Nikhil-Vishnoi/RobotHand/BOM.xlsx

Sheet: ServoController
Servo Controller
Reference | Qty | Value | DNP | Exclude from BOM | Exclude from Board | Footprint | Datasheet | Digikey Link
C1,C2,C5,C6,C7,C4 | 6 | .1u |  |  |  | Capacitor_SMD:C_0504_1310Metric_Pad0.83x1.28mm_HandSolder | ~ | https://www.digikey.com/en/products/detail/passive-plus/0505P101JW151X/16687460?gad_campaignid=17922795960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
C3 | 1 | 1 |  |  |  | Capacitor_SMD:C_0504_1310Metric_Pad0.83x1.28mm_HandSolder | ~ | https://www.digikey.com/en/products/detail/murata-electronics/GRM155R70J105KA12D/5026378
D1 | 1 | ASMB-MTB0-0A3A2 |  |  |  | LED_SMD:LED_Avago_PLCC4_3.2x2.8mm_CW | https://docs.broadcom.com/docs/AV02-4186EN | https://www.mouser.com/ProductDetail/Broadcom-Avago/ASMB-MTB0-0B3A2?qs=pUKx8fyJudDHauriy4v3sw%3D%3D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
D2,D3 | 2 | LED |  |  |  | LED_SMD:LED_1206_3216Metric_Pad1.42x1.75mm_HandSolder | ~ | https://www.digikey.com/en/products/detail/everlight-electronics-co-ltd/QTLP650D4TR-QT15-21SYGD-S530-E2-TR8/2676153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
J1,J2,J3,J4,J7 | 5 | Conn_01x03_Pin |  |  |  | Connector_PinHeader_2.54mm:PinHeader_1x03_P2.54mm_Horizontal | ~ | https://www.digikey.com/en/products/detail/w-rth-elektronik/61300311021/4846824?gclsrc=aw.ds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
J5 | 1 | Conn_01x05_Pin |  |  |  | Connector_PinHeader_2.54mm:PinHeader_1x05_P2.54mm_Vertical | ~ | https://www.digikey.com/en/products/detail/te-connectivity-amp-connectors/9-146282-0-05/1125902?gclsrc=aw.ds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
J6 | 1 | Conn_01x02_Socket |  |  |  | Connector_PinSocket_2.54mm:PinSocket_1x02_P2.54mm_Horizontal | ~ | https://www.digikey.com/en/products/detail/sullins-connector-solutions/PPTC021LGBN-RC/775896
J8 | 1 | Barrel_Jack |  |  |  | Connector_BarrelJack:BarrelJack_Wuerth_694106106102_2.0x5.5mm | ~ | https://www.digikey.com/en/products/detail/w-rth-elektronik/694106301002/5047522?gclsrc=aw.ds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
J9 | 1 | Conn_01x06_Socket |  |  |  | Connector_PinSocket_2.54mm:PinSocket_1x06_P2.54mm_Vertical | ~ | https://www.digikey.com/en/products/detail/sullins-connector-solutions/PBC06SFCN/859987?gclsrc=aw.ds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
J10 | 1 | Conn_01x01_Pin |  |  |  | Connector_PinHeader_2.54mm:PinHeader_1x01_P2.54mm_Vertical | ~ | https://www.digikey.com/en/products/detail/te-connectivity-amp-connectors/5-146277-3/5008686?gclsrc=aw.ds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
R1,R3,R4,R2 | 4 | 270 |  |  |  | Resistor_SMD:R_0805_2012Metric_Pad1.20x1.40mm_HandSolder | ~ | https://www.digikey.com/en/products/detail/panasonic-electronic-components/ERJ-6GEYJ271V/89712
TP1,TP2,TP3 | 3 | TestPoint |  |  |  | TestPoint:TestPoint_Pad_2.5x2.5mm | ~ | Already on Board
U1 | 1 | PCA9685PW |  |  |  | Package_SO:TSSOP-28_4.4x9.7mm_P0.65mm | http://www.nxp.com/docs/en/data-sheet/PCA9685.pdf | Have
U2 | 1 | NORA-W106-00B |  |  |  | NORA-W106-00B:XCVR_NORA-W106-00B |  | Have
U3 | 1 | TC1262-33 |  |  |  | Package_TO_SOT_SMD:SOT-223-3_TabPin2 | http://ww1.microchip.com/downloads/en/DeviceDoc/21373C.pdf | https://www.digikey.com/en/products/detail/microchip-technology/TC1262-3-3VDB/1980071?gclsrc=aw.ds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
U4 | 1 | STM32L031K6Tx |  |  |  | Package_QFP:LQFP-32_7x7mm_P0.8mm | https://www.st.com/resource/en/datasheet/stm32l031k6.pdf | Get from supply closet
Servo | 5 |  |  |  |  |  |  | https://www.digikey.com/en/products/detail/hitec-commercial-solutions/31311S/12148509?gclsrc=aw.ds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
Remort Controller
Reference | Qty | Value | DNP | Exclude from BOM | Exclude from Board | Footprint | Datasheet | Digikey Buy Link
C1,C3,C4,C5,C6,C7 | 6 | .1u |  |  |  | Capacitor_SMD:C_0504_1310Metric_Pad0.83x1.28mm_HandSolder | ~ | https://www.mouser.com/ProductDetail/Samsung-Electro-Mechanics/CL05A105KQ5NNNC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
C2 | 1 | 1 |  |  |  | Capacitor_SMD:C_0504_1310Metric_Pad0.83x1.28mm_HandSolder | ~ | https://www.digikey.com/en/products/detail/murata-electronics/GRM155R70J105KA12D/5026378
D1,D2 | 2 | LED |  |  |  | LED_SMD:LED_1206_3216Metric_Pad1.42x1.75mm_HandSolder | ~ | https://www.digikey.com/en/products/detail/everlight-electronics-co-ltd/QTLP650D4TR-QT15-21SYGD-S530-E2-TR8/2676153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
D4 | 1 | ASMB-MTB0-0A3A2 |  |  |  | LED_SMD:LED_Avago_PLCC4_3.2x2.8mm_CW | https://docs.broadcom.com/docs/AV02-4186EN | https://www.mouser.com/ProductDetail/Broadcom-Avago/ASMB-MTB0-0B3A2?qs=pUKx8fyJudDHauriy4v3sw%3D%3D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
J1 | 1 | Barrel_Jack |  |  |  | Connector_BarrelJack:BarrelJack_Wuerth_694106106102_2.0x5.5mm | ~ | https://www.digikey.com/en/products/detail/w-rth-elektronik/694106301002/5047522?gclsrc=aw.ds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
J3 | 1 | Conn_01x05_Pin |  |  |  | Connector_PinHeader_2.54mm:PinHeader_1x05_P2.54mm_Vertical | ~ | https://www.digikey.com/en/products/detail/te-connectivity-amp-connectors/9-146282-0-05/1125902?gclsrc=aw.ds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
J4,J6,J7,J8,J9,J11 | 6 | Conn_01x02_Socket |  |  |  | Connector_PinSocket_2.54mm:PinSocket_1x02_P2.54mm_Horizontal | ~ | https://www.digikey.com/en/products/detail/sullins-connector-solutions/PPTC021LGBN-RC/775896
J5 | 1 | Conn_01x06_Socket |  |  |  | Connector_PinHeader_2.54mm:PinHeader_1x06_P2.54mm_Vertical | ~ | https://www.digikey.com/en/products/detail/sullins-connector-solutions/PBC06SFCN/859987?gclsrc=aw.ds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
J10 | 1 | Conn_01x01_Pin |  |  |  | Connector_PinHeader_2.54mm:PinHeader_1x01_P2.54mm_Vertical | ~ | https://www.digikey.com/en/products/detail/te-connectivity-amp-connectors/5-146277-3/5008686?gclsrc=aw.ds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
R1,R8,R9,R7 | 2 | 270 |  |  |  | Resistor_SMD:R_0805_2012Metric_Pad1.20x1.40mm_HandSolder | ~ | https://www.digikey.com/en/products/detail/panasonic-electronic-components/ERJ-6GEYJ271V/89712
R2,R3,R4,R5,R6 | 5 | 200k |  |  |  | Resistor_SMD:R_0805_2012Metric_Pad1.20x1.40mm_HandSolder | ~ | https://www.digikey.com/en/products/detail/yageo/RC0805JR-07220RL/728283
R11,R13,R14,R17,R19 | 5 | 10k |  |  |  | Resistor_SMD:R_0805_2012Metric_Pad1.20x1.40mm_HandSolder | ~ | https://www.digikey.com/en/products/detail/yageo/RC0805FR-0710KL/727535
R10,R12,R15,R16,R18 | 17 | 5k |  |  |  | Resistor_SMD:R_0805_2012Metric_Pad1.20x1.40mm_HandSolder | ~ | https://www.digikey.com/en/products/detail/vishay-dale/CRCW08055K00FKTA/5075661
TP1,TP2,TP3,TP4,TP5,TP6,TP7,TP8,TP9,TP10,TP11 | 11 | TestPoint |  |  |  | TestPoint:TestPoint_Pad_2.5x2.5mm | ~ | Already on Board
U1 | 1 | STM32L031K6Tx |  |  |  | Package_QFP:LQFP-32_7x7mm_P0.8mm | https://www.st.com/resource/en/datasheet/stm32l031k6.pdf | Get from the supply closet
U2 | 1 | TC1262-33 |  |  |  | Package_TO_SOT_SMD:SOT-223-3_TabPin2 | http://ww1.microchip.com/downloads/en/DeviceDoc/21373C.pdf | https://www.digikey.com/en/products/detail/microchip-technology/TC1262-3-3VDB/1980071?gclsrc=aw.ds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
U3 | 1 | NORA-W106-00B |  |  |  | NORA-W106-00B:XCVR_NORA-W106-00B |  | Have
U4,U5,U6,U7,U8 | 5 | LM358APE4 |  |  |  | lm358:P8 | https://www.ti.com/lit/gpn/lm358 | https://www.digikey.com/en/products/detail/texas-instruments/LM358APE4/18159207
 | 5

Sheet: Total
Reference | Qty | Value | DNP | Exclude from BOM | Exclude from Board | Footprint | Datasheet | Digikey Link | Alternatives
C1,C2,C5,C6,C7,C4 | 12 | .1u |  |  |  | Capacitor_SMD:C_0504_1310Metric_Pad0.83x1.28mm_HandSolder | ~ |  | https://www.mouser.com/ProductDetail/KYOCERA-AVX/KGM05AR71C104KN?qs=Jm2GQyTW%2FbgdxRIzvEDaJg%3D%3D
C3 | 2 | 1 |  |  |  | Capacitor_SMD:C_0504_1310Metric_Pad0.83x1.28mm_HandSolder | ~ | https://www.digikey.com/en/products/detail/murata-electronics/GRM155R70J105KA12D/5026378 | -
D1 | 2 | ASMB-MTB0-0A3A2 |  |  |  | LED_SMD:LED_Avago_PLCC4_3.2x2.8mm_CW | https://docs.broadcom.com/docs/AV02-4186EN | https://www.mouser.com/ProductDetail/Broadcom-Avago/ASMB-MTB0-0B3A2?qs=pUKx8fyJudDHauriy4v3sw%3D%3D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 | -
D2,D3 | 4 | LED |  |  |  | LED_SMD:LED_1206_3216Metric_Pad1.42x1.75mm_HandSolder | ~ | https://www.digikey.com/en/products/detail/everlight-electronics-co-ltd/QTLP650D4TR-QT15-21SYGD-S530-E2-TR8/2676153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 | -
R1,R8,R9,R7 | 8 | 330 |  |  |  | Resistor_SMD:R_0805_2012Metric_Pad1.20x1.40mm_HandSolder | ~ | https://www.digikey.com/en/products/detail/panasonic-electronic-components/ERJ-6GEYJ271V/89712 | ECEB Store Has it Dont Buy
R2,R3,R4,R5,R6 | 5 | 200k |  |  |  | Resistor_SMD:R_0805_2012Metric_Pad1.20x1.40mm_HandSolder | ~ | https://www.digikey.com/en/products/detail/yageo/RT0805BRE07200KL/1076266 | -
R11,R13,R14,R17,R19 | 5 | 1.5k |  |  |  | Resistor_SMD:R_0805_2012Metric_Pad1.20x1.40mm_HandSolder | ~ | https://www.digikey.com/en/products/detail/yageo/RC0805FR-0710KL/727535 | ECEB Store Has it Dont Buy
R10,R12,R15,R16,R18 | 17 | 1k |  |  |  | Resistor_SMD:R_0805_2012Metric_Pad1.20x1.40mm_HandSolder | ~ | https://www.digikey.com/en/products/detail/vishay-dale/CRCW08055K00FKTA/5075661 | ECEB Store Has it Dont Buy
U4,U5,U6,U7,U8 | 5 | LM358APE4 |  |  |  | lm358:P8 | https://www.ti.com/lit/gpn/lm358 | https://www.digikey.com/en/products/detail/texas-instruments/LM358APE4/18159207 | -
J1,J2,J3,J4,J7 | 5 | Conn_01x03_Pin |  |  |  | Connector_PinHeader_2.54mm:PinHeader_1x03_P2.54mm_Horizontal | ~ | https://www.digikey.com/en/products/detail/w-rth-elektronik/61300311021/4846824?gclsrc=aw.ds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 | -
J5 | 2 | Conn_01x05_Pin |  |  |  | Connector_PinHeader_2.54mm:PinHeader_1x05_P2.54mm_Vertical | ~ | https://www.digikey.com/en/products/detail/te-connectivity-amp-connectors/9-146282-0-05/1125902?gclsrc=aw.ds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 | -
J6 | 7 | Conn_01x02_Socket |  |  |  | Connector_PinSocket_2.54mm:PinSocket_1x02_P2.54mm_Horizontal | ~ | https://www.digikey.com/en/products/detail/sullins-connector-solutions/PPTC021LGBN-RC/775896 | -
J8 | 2 | Barrel_Jack |  |  |  | Connector_BarrelJack:BarrelJack_Wuerth_694106106102_2.0x5.5mm | ~ | https://www.digikey.com/en/products/detail/w-rth-elektronik/694106301002/5047522?gclsrc=aw.ds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 | -
J9 | 2 | Conn_01x06_Socket |  |  |  | Connector_PinSocket_2.54mm:PinSocket_1x06_P2.54mm_Vertical | ~ | https://www.digikey.com/en/products/detail/sullins-connector-solutions/PBC06SFCN/859987?gclsrc=aw.ds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 | -
J10 | 2 | Conn_01x01_Pin |  |  |  | Connector_PinHeader_2.54mm:PinHeader_1x01_P2.54mm_Vertical | ~ | https://www.digikey.com/en/products/detail/te-connectivity-amp-connectors/5-146277-3/5008686?gclsrc=aw.ds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 | -
U1 | 1 | PCA9685PW |  |  |  | Package_SO:TSSOP-28_4.4x9.7mm_P0.65mm | http://www.nxp.com/docs/en/data-sheet/PCA9685.pdf | Have
U2 | 2 | NORA-W106-00B |  |  |  | NORA-W106-00B:XCVR_NORA-W106-00B |  | Have
U3 | 2 | TC1262-33 |  |  |  | Package_TO_SOT_SMD:SOT-223-3_TabPin2 | http://ww1.microchip.com/downloads/en/DeviceDoc/21373C.pdf | https://www.digikey.com/en/products/detail/microchip-technology/TC1262-3-3VDB/1980071?gclsrc=aw.ds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 | -
U4 | 6 | STM32L031K6Tx |  |  |  | Package_QFP:LQFP-32_7x7mm_P0.8mm | https://www.st.com/resource/en/datasheet/stm32l031k6.pdf | https://www.digikey.com/en/products/detail/stmicroelectronics/STM32L031K6T6/6166978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..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 | -
Charger | 2 |  |  |  |  |  |  | https://www.walmart.com/ip/JacobsParts-5V-4A-20W-Power-Adapter-for-USB-Hubs-and-Other-5V-Devices-5-5mm-x-2-1mm/5750976615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 | -
Servo | 3 |  |  |  |  |  |  | https://hitecrcd.com/hs-311-standard-economy-servo/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 | -
Battery Pack | 1 |  |  |  |  |  |  | https://www.digikey.com/en/products/detail/digikey-standard/DKS-2AAF/17038790?gclsrc=aw.ds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 | -
Digikey Order | https://www.digikey.com/short/3p9089w3
Mouser Order | https://www.mouser.com/Tools/SavedCart/Share?AccessID=e82e5d9639
