Nikhil-Vishnoi/RobotHand/PCB/RemoteControl/RemoteControl.kicad_pcb

## KiCad design PCB/RemoteControl/RemoteControl.kicad_pcb (2025-10-26)

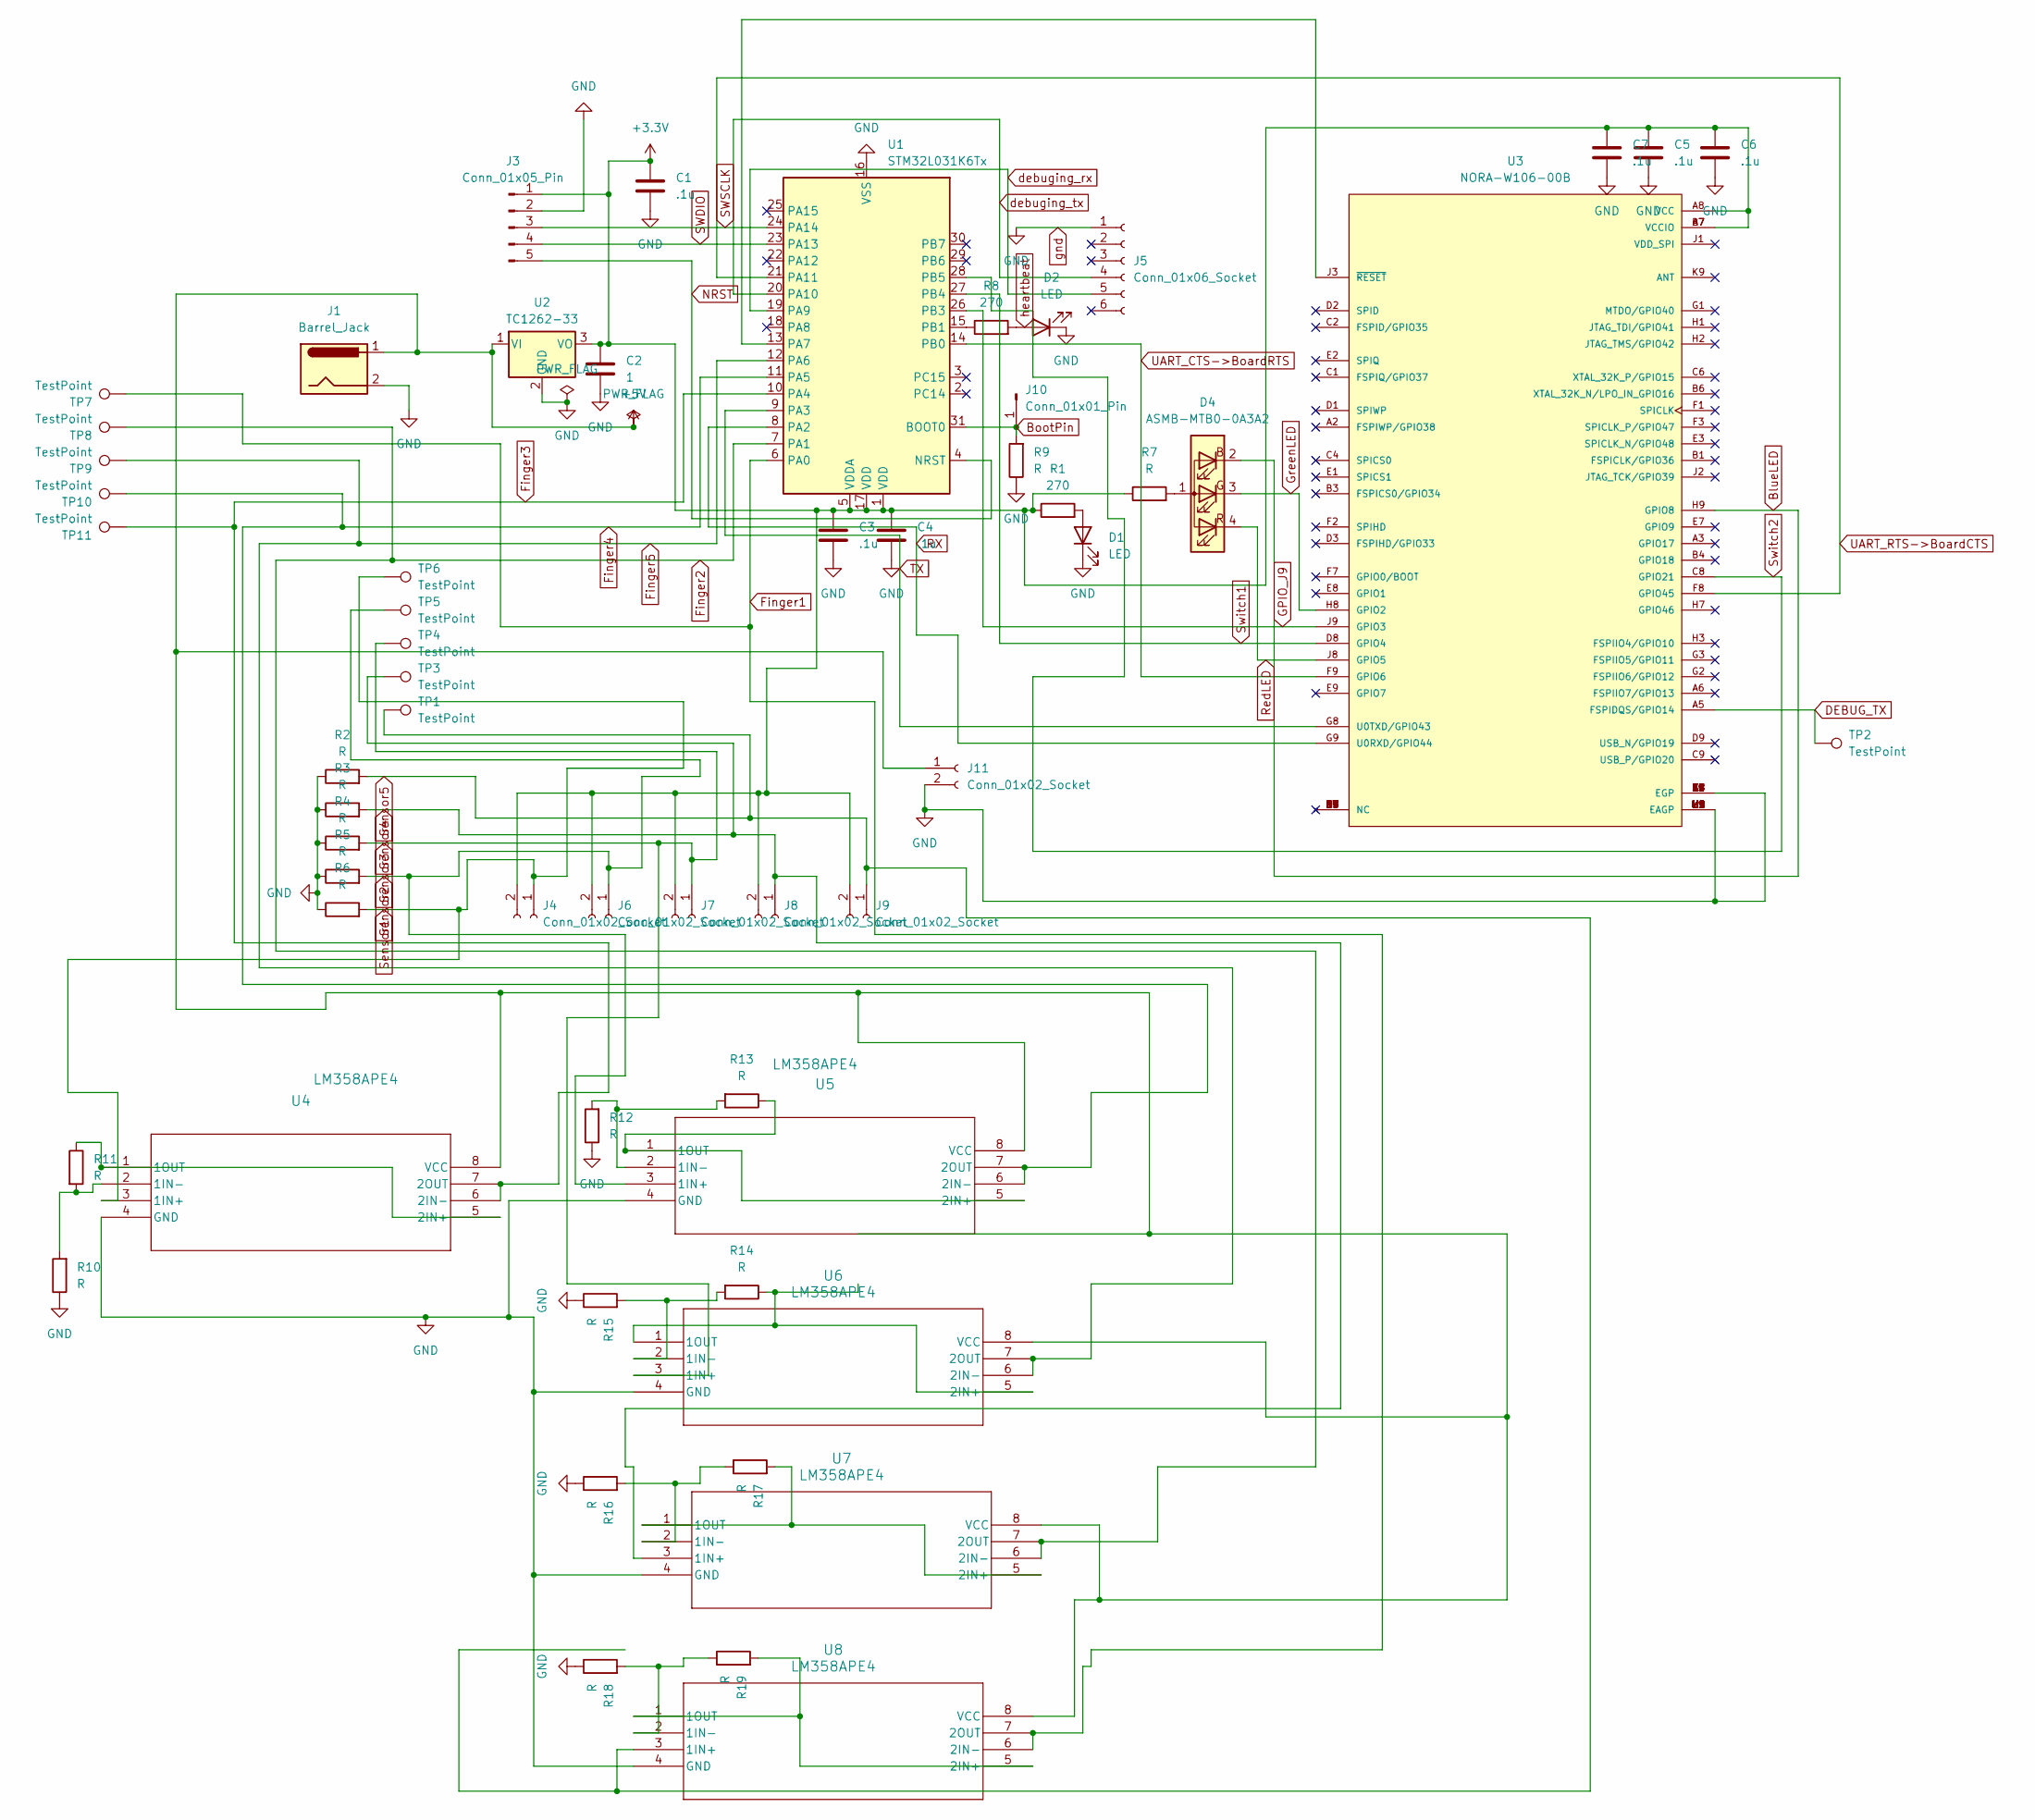
[picture p1: schematic RemoteControl.kicad_sch]

Parts:
C1, C3, C4, C5, C6, C7: .1u; C_0805_2012Metric_Pad1.18x1.45mm_HandSolder
C2: 1; C_0805_2012Metric_Pad1.18x1.45mm_HandSolder
D1, D2: LED; LED_1206_3216Metric_Pad1.42x1.75mm_HandSolder
D4: ASMB-MTB0-0A3A2; LED_Avago_PLCC4_3.2x2.8mm_CW
J1: Barrel_Jack; BarrelJack_Wuerth_694106106102_2.0x5.5mm
J3: Conn_01x05_Pin; PinHeader_1x05_P2.54mm_Vertical
J4, J6, J7, J8, J9, J11: Conn_01x02_Socket; PinSocket_1x02_P2.54mm_Horizontal
J5: Conn_01x06_Socket; PinHeader_1x06_P2.54mm_Vertical
J10: Conn_01x01_Pin; PinHeader_1x01_P2.54mm_Vertical
R1, R8: 270; R_0805_2012Metric_Pad1.20x1.40mm_HandSolder
R2, R3, R4, R5, R6, R7, R9, R10, R11, R12, R13, R14, R15, R16, R17, R18, R19: R; R_0805_2012Metric_Pad1.20x1.40mm_HandSolder
TP1, TP2, TP3, TP4, TP5, TP6, TP7, TP8, TP9, TP10, TP11: TestPoint; TestPoint_Pad_2.5x2.5mm
U1: STM32L031K6Tx; LQFP-32_7x7mm_P0.8mm
U2: TC1262-33; SOT-223-3_TabPin2
U3: NORA-W106-00B; XCVR_NORA-W106-00B; PARTREV R03
U4, U5, U6, U7, U8: LM358APE4; P8

Connections:
+3.3V: C1.1, C2.1, C3.1, C4.1, C5.1, C6.1, C7.1, J3.1, J4.2, J6.2, J7.2, J8.2, J9.2, R1.1, R7.1, U1.1 (VDD), U1.5 (VDDA), U1.17 (VDD), U2.3 (VO), U3.A7 (VCCIO), U3.A8 (VCC), U3.B7 (VCCIO)
+5V: J1.1, J11.1, U2.1 (VI), U4.8 (VCC), U5.8 (VCC), U6.8 (VCC), U7.8 (VCC), U8.8 (VCC)
BlueLED: D4.2 (BK), U3.H9 (GPIO8)
BootPin: J10.1, R9.2, U1.31 (BOOT0)
DEBUG_TX: TP2.1, U3.A5 (FSPIDQS/GPIO14)
Finger1: TP7.1, U1.6 (PA0), U8.6 (2IN-), U8.7 (2OUT)
Finger2: TP8.1, U1.7 (PA1), U7.6 (2IN-), U7.7 (2OUT)
Finger3: TP11.1, U1.10 (PA4), U4.6 (2IN-), U4.7 (2OUT)
Finger4: TP10.1, U1.11 (PA5), U5.6 (2IN-), U5.7 (2OUT)
Finger5: TP9.1, U1.12 (PA6), U6.6 (2IN-), U6.7 (2OUT)
GPIO_J9: U1.26 (PB3), U3.J9 (GPIO3)
GreenLED: D4.3 (GK), U3.H8 (GPIO2)
NRST: J3.5, U1.4 (NRST)
unnamed: D1.2 (A), R1.2
unnamed: D2.2 (A), R8.2
unnamed: D4.1 (A), R7.2
unnamed: U1.13 (PA7), U3.J3 (~RESET)
unnamed: R8.1, U1.15 (PB1)
unnamed: R10.2, R11.2, U4.2 (1IN-)
unnamed: R11.1, U4.1 (1OUT), U4.5 (2IN+)
unnamed: R12.2, R13.2, U5.2 (1IN-)
unnamed: R13.1, U5.1 (1OUT), U5.5 (2IN+)
unnamed: R14.2, R15.2, U6.2 (1IN-)
unnamed: R14.1, U6.1 (1OUT), U6.5 (2IN+)
unnamed: R16.2, R17.1, U7.2 (1IN-)
unnamed: R17.2, U7.1 (1OUT), U7.5 (2IN+)
unnamed: R18.2, R19.1, U8.2 (1IN-)
unnamed: R19.2, U8.1 (1OUT), U8.5 (2IN+)
RX: U1.8 (PA2), U3.G9 (U0RXD/GPIO44)
RedLED: D4.4 (RK), U3.J8 (GPIO5)
SWDIO: J3.4, U1.23 (PA13)
SWSCLK: J3.3, U1.24 (PA14)
Sensor1: J4.1, R6.2, TP6.1, U4.3 (1IN+)
Sensor2: J6.1, R5.2, TP5.1, U5.3 (1IN+)
Sensor3: J7.1, R4.2, TP4.1, U6.3 (1IN+)
Sensor4: J8.1, R3.2, TP3.1, U7.3 (1IN+)
Sensor5: J9.1, R2.2, TP1.1, U8.3 (1IN+)
Switch1: U1.27 (PB4), U3.D8 (GPIO4)
Switch2: U1.28 (PB5), U3.C8 (GPIO21)
TX: U1.9 (PA3), U3.G8 (U0TXD/GPIO43)
UART_CTS->BoardRTS: U1.14 (PB0), U3.F9 (GPIO6)
UART_RTS->BoardCTS: U1.21 (PA11), U3.F8 (GPIO45)
debuging_rx: J5.5, U1.19 (PA9)
debuging_tx: J5.4, U1.20 (PA10)
gnd: C1.2, C2.2, C3.2, C4.2, C5.2, C6.2, C7.2, D1.1 (K), D2.1 (K), J1.2, J3.2, J5.1, J11.2, R2.1, R3.1, R4.1, R5.1, R6.1, R9.1, R10.1, R12.1, R15.1, R16.1, R18.1, U1.16 (VSS), U1.32 (VSS), U2.2 (GND), U3.A1 (EGP), U3.A9 (EGP), U3.B2 (EGP), U3.B8 (EGP), U3.E4 (EGP), U3.E5 (EGP), U3.F4 (EGP), U3.F5 (EGP), U3.K2 (EGP), U3.K3 (EGP), U3.K5 (EGP), U3.K7 (EGP), U3.K8 (EGP), U3.L1 (EAGP), U3.L9 (EAGP), U3.M1 (EAGP), U3.M2 (EAGP), U3.M8 (EAGP), U3.M9 (EAGP), U4.4 (GND), U5.4 (GND), U6.4 (GND), U7.4 (GND), U8.4 (GND)

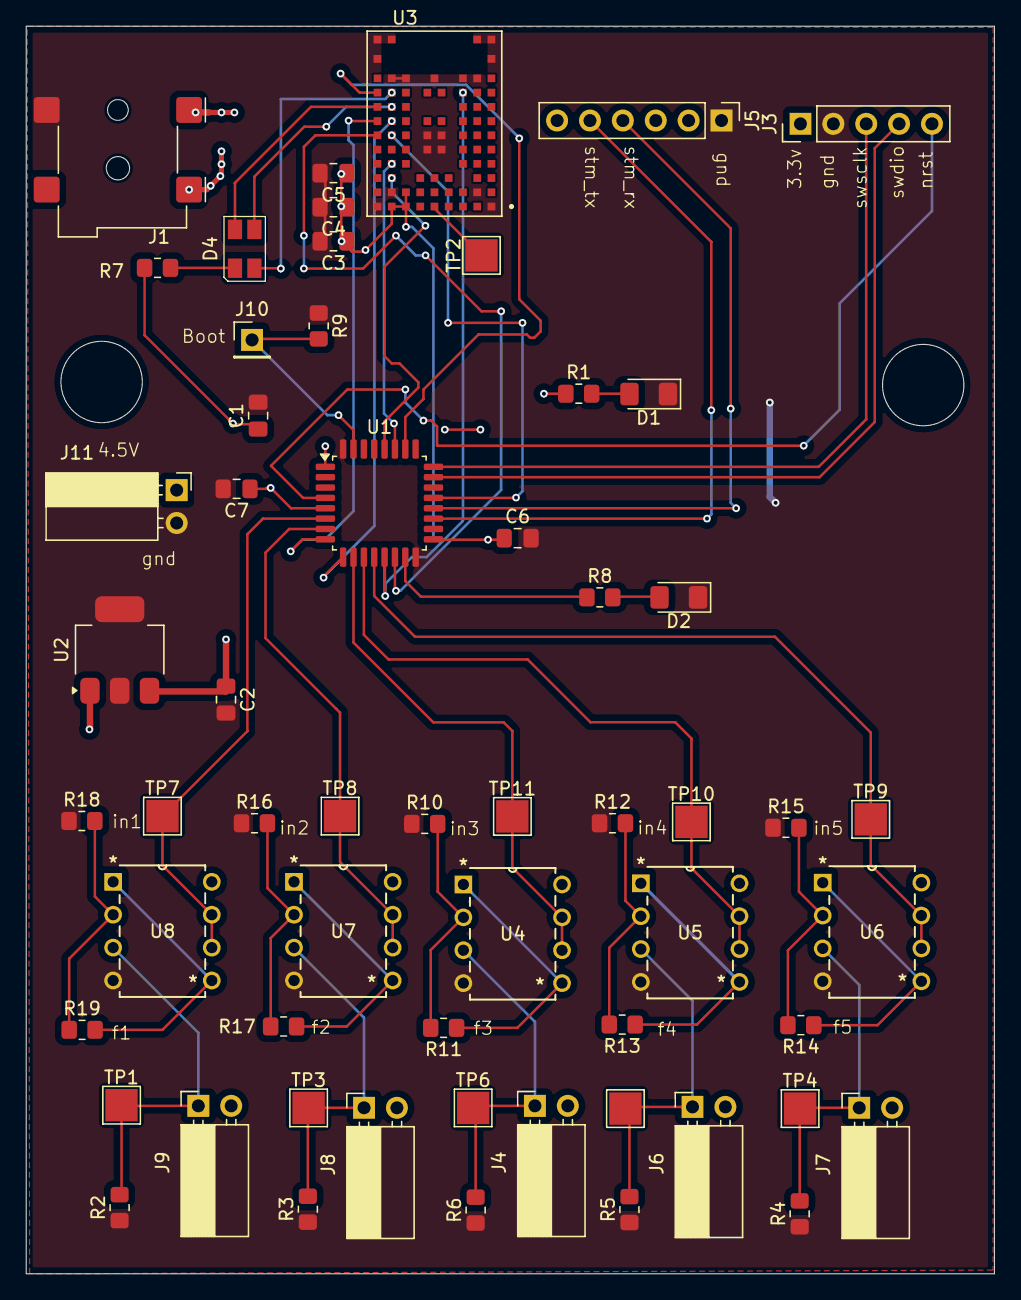
[picture p2: board RemoteControl.kicad_pcb from above]

Board: 2 copper layers, 74.8 x 96.4 mm, 58 parts (0 on the bottom side), 45 nets.
