Nikhil-Vishnoi/RobotHand/PCB/MotorControl/MotorControl.kicad_pcb

## KiCad design PCB/MotorControl/MotorControl.kicad_pcb (2025-10-26)

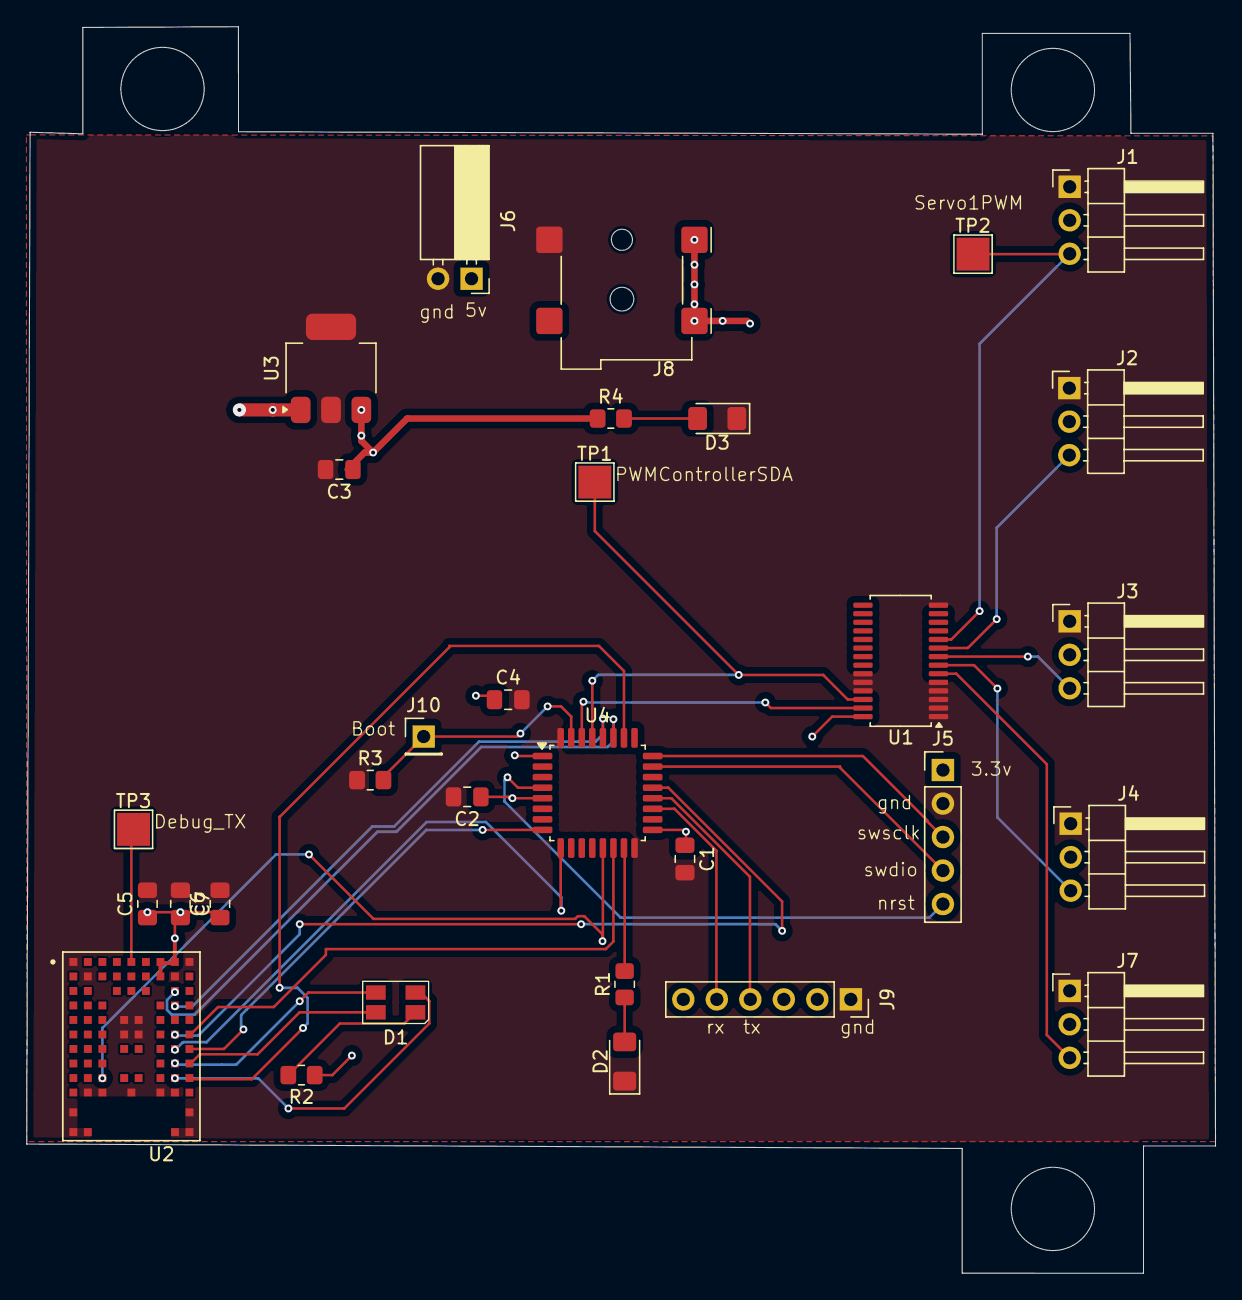
[picture p3: board MotorControl.kicad_pcb from above]

Board: 2 copper layers, 90.1 x 94.5 mm, 31 parts (0 on the bottom side), 32 nets.

Parts:
C1, C2, C5, C6, C7: C; C_0805_2012Metric_Pad1.18x1.45mm_HandSolder
C3: 1; C_0805_2012Metric_Pad1.18x1.45mm_HandSolder
C4: .1u; C_0805_2012Metric_Pad1.18x1.45mm_HandSolder
D1: ASMB-MTB0-0A3A2; LED_Avago_PLCC4_3.2x2.8mm_CW
D2, D3: LED; LED_1206_3216Metric_Pad1.42x1.75mm_HandSolder
J1, J2, J3, J4, J7: Conn_01x03_Pin; PinHeader_1x03_P2.54mm_Horizontal
J5: Conn_01x05_Pin; PinHeader_1x05_P2.54mm_Vertical
J6: Conn_01x02_Socket; PinSocket_1x02_P2.54mm_Horizontal
J8: Barrel_Jack; BarrelJack_Wuerth_694106106102_2.0x5.5mm
J9: Conn_01x06_Socket; PinSocket_1x06_P2.54mm_Vertical
J10: Conn_01x01_Pin; PinHeader_1x01_P2.54mm_Vertical
R1, R3, R4: 270; R_0805_2012Metric_Pad1.20x1.40mm_HandSolder
R2: R; R_0805_2012Metric_Pad1.20x1.40mm_HandSolder
TP1, TP2, TP3: TestPoint; TestPoint_Pad_2.5x2.5mm
U1: PCA9685PW; TSSOP-28_4.4x9.7mm_P0.65mm
U2: NORA-W106-00B; XCVR_NORA-W106-00B
U3: TC1262-33; SOT-223-3_TabPin2
U4: STM32L031K6Tx; LQFP-32_7x7mm_P0.8mm

Connections:
5V: J1.2, J2.2, J3.2, J4.2, J6.1, J7.2, J8.1, U3.1 (VI)
+3.3V: C1.1, C2.1, C3.1, C4.1, C5.1, C6.1, C7.2, J5.1, R2.1, R4.1, U1.28 (VDD), U2.A7 (VCCIO), U2.A8 (VCC), U2.B7 (VCCIO), U3.3 (VO), U4.1 (VDD), U4.5 (VDDA), U4.17 (VDD)
BlueLED: D1.2 (BK), U2.H9 (GPIO8)
Boot: J10.1, R3.2, U4.31 (BOOT0)
DebugTX: TP3.1, U2.A5 (FSPIDQS/GPIO14)
Debug_rx: J9.5, U4.19 (PA9)
Debug_tx: J9.4, U4.20 (PA10)
GND: C1.2, C2.2, C3.2, C4.2, C5.2, C6.2, C7.1, D2.1 (K), D3.1 (K), J1.1, J2.1, J3.1, J4.1, J5.2, J6.2, J7.1, J8.2, J9.1, R3.1, U1.1 (A0), U1.2 (A1), U1.3 (A2), U1.4 (A3), U1.5 (A4), U1.14 (VSS), U1.23 (~OE), U1.24 (A5), U1.25 (EXTCLK), U2.A1 (EGP), U2.A9 (EGP), U2.B2 (EGP), U2.B8 (EGP), U2.E4 (EGP), U2.E5 (EGP), U2.F4 (EGP), U2.F5 (EGP), U2.K2 (EGP), U2.K3 (EGP), U2.K5 (EGP), U2.K7 (EGP), U2.K8 (EGP), U2.L1 (EAGP), U2.L9 (EAGP), U2.M1 (EAGP), U2.M2 (EAGP), U2.M8 (EAGP), U2.M9 (EAGP), U3.2 (GND), U4.16 (VSS), U4.32 (VSS)
GPIO_J9: U2.J9 (GPIO3), U4.26 (PB3)
GreenLED: D1.3 (GK), U2.H8 (GPIO2)
HeartBeat: R1.2, U4.15 (PB1)
Motor1PWM: J1.3, TP2.1, U1.10 (LED4)
MotorControl_SCL: TP1.1, U1.26 (SCL), U4.29 (PB6)
NRST: J5.5, U4.4 (NRST)
unnamed: D1.1 (A), R2.2
unnamed: D2.2 (A), R1.1
unnamed: D3.2 (A), R4.2
unnamed: J2.3, U1.9 (LED3)
unnamed: J3.3, U1.8 (LED2)
unnamed: J4.3, U1.7 (LED1)
unnamed: J7.3, U1.6 (LED0)
unnamed: U1.27 (SDA), U4.30 (PB7)
unnamed: U2.J3 (~RESET), U4.13 (PA7)
RX: U2.G8 (U0TXD/GPIO43), U4.9 (PA3)
RedLED: D1.4 (RK), U2.J8 (GPIO5)
SWDIO: J5.4, U4.23 (PA13)
SWSCLK: J5.3, U4.24 (PA14)
Switch1: U2.D8 (GPIO4), U4.28 (PB5)
Switch2: U2.C8 (GPIO21), U4.27 (PB4)
TX: U2.G9 (U0RXD/GPIO44), U4.8 (PA2)
UART_CTS->Board_RTS: U2.F9 (GPIO6), U4.14 (PB0)
UART_RTS->Board_CTS: U2.F8 (GPIO45), U4.21 (PA11)
