Nikhil-Vishnoi/RobotHand/STM32_Remote/Core/Src/main.c

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
/* Includes ------------------------------------------------------------------*/
#include "main.h"

/* USER CODE BEGIN Includes */
#include "Nora.h"
/* USER CODE END Includes */

ADC_HandleTypeDef hadc;
DMA_HandleTypeDef hdma_adc;

UART_HandleTypeDef hlpuart1;
UART_HandleTypeDef huart2;

void SystemClock_Config(void);
static void MX_GPIO_Init(void);
static void MX_DMA_Init(void);
static void MX_ADC_Init(void);
static void MX_LPUART1_UART_Init(void);
static void MX_USART2_UART_Init(void);
/* USER CODE BEGIN PFP */
UART_HandleTypeDef* getNoraPort(){
	return &hlpuart1;
}
UART_HandleTypeDef* getDebugPort(){
	return &huart2;
}
/* USER CODE END PFP */

/**
  * @brief  The application entry point.
  * @retval int
  */
int main(void)
{

  /* MCU Configuration--------------------------------------------------------*/

  /* Reset of all peripherals, Initializes the Flash interface and the Systick. */
  HAL_Init();

  /* Configure the system clock */
  SystemClock_Config();

  /* Initialize all configured peripherals */
  MX_GPIO_Init();
  MX_DMA_Init();
  MX_ADC_Init();
  MX_LPUART1_UART_Init();
  MX_USART2_UART_Init();
  /* USER CODE BEGIN 2 */
//  // boot up uconnect press
//  Nora_startup();

  static uint16_t adc_val[5];
  HAL_ADC_Start_DMA(&hadc, adc_val, 5);
  int thm, im, mm, rm, pm, ths, is, ms, rs, ps;
  thm = -1;
  im = -1;
  mm = -1;
  rm = -1;
  pm = -1;
  ths = -1;
  is = -1;
  ms = -1;
  rs = -1;
  ps = -1;
  /* USER CODE END 2 */

  /* Infinite loop */
  /* USER CODE BEGIN WHILE */
  while (1)
  {
    /* USER CODE END WHILE */

    /* USER CODE BEGIN 3 */
//	  i++;
//	  Nora_command("AT\r\n");
	  HAL_ADC_Start(&hadc);
	  HAL_Delay(50);
	  HAL_GPIO_WritePin(LED_GPIO_Port, LED_Pin, GPIO_PIN_SET);
	  char str_buffer[500];
	  if(thm == -1 || thm < adc_val[4]) {
		  thm = adc_val[4];
	  }
	  if(im == -1 || im < adc_val[3]) {
		  im = adc_val[3];
	  }
	  if(mm == -1 || mm < adc_val[2]) {
		  mm = adc_val[2];
	  }
	  if(rm == -1 || rm < adc_val[1]) {
		  rm = adc_val[1];
	  }
	  if(pm == -1 || pm < adc_val[0]) {
		  pm = adc_val[0];
	  }
	  if(ths == -1) {
		  ths = adc_val[4]/2;
	  }
	  if(is == -1) {
		  is = adc_val[3]/2;
	  }
	  if(ms == -1 ) {
		  ms = adc_val[2]/2;
	  }
	  if(rs == -1) {
		  rs = adc_val[1]/2;
	  }
	  if(ps == -1) {
		  ps = adc_val[0]/2;
	  }
	  if(ths > adc_val[4]) {
		  ths = adc_val[4];
	  }
	  if(is > adc_val[3]) {
		  is = adc_val[3];
	  }
	  if(ms > adc_val[2]) {
		  ms = adc_val[2];
	  }
	  if(rs > adc_val[1]) {
		  rs = adc_val[1];
	  }
	  if(ps > adc_val[0]) {
		  ps = adc_val[0];
	  }



//	  sprintf(str_buffer,"\r\nPinky: %u | Ring: %u | Middle 3: %u | Index 4: %u | Thumb 5: %u \r\n\0",adc_val[0],adc_val[1],adc_val[2],adc_val[3],adc_val[4]);
//
////	  if(i == 1)
//	  HAL_UART_Transmit(&huart2,str_buffer,strlen(str_buffer),5000);
//	  sprintf(str_buffer,"\r\nMaxes Pinky: %u | Ring: %u | Middle 3: %u | Index 4: %u | Thumb 5: %u \r\n\0",
//			  pm,rm,mm,im,thm);
//	  HAL_UART_Transmit(&huart2,str_buffer,strlen(str_buffer),5000);
//	  sprintf(str_buffer,"\r\nMins Pinky: %u | Ring: %u | Middle 3: %u | Index 4: %u | Thumb 5: %u \r\n\0",
//			  ps,rs,ms,is,ths);
//	  HAL_UART_Transmit(&huart2,str_buffer,strlen(str_buffer),5000);
//	  sprintf(str_buffer,
//	      "\r\nAngles Pinky: %3d | Ring: %3d | Middle: %3d | Index: %3d | Thumb: %3d\r\n\0",
//	      (adc_val[0] - ps) * 180 / (pm - ps),
//	      (adc_val[1] - rs) * 180 / (rm - rs),
//	      (adc_val[2] - ms) * 180 / (mm - ms),
//	      (adc_val[3] - is) * 180 / (im - is),
//	      (adc_val[4] - ths) * 180 / (thm - ths)
//	  );
	  sprintf(str_buffer,
	  	      "%c%c%c%c%c",
	  	      (adc_val[0] - ps) * 180 / (pm - ps),
			  (adc_val[1] - rs) * 180 / (rm - rs),
			  180-(adc_val[2] - ms) * 180 / (mm - ms),
			  (adc_val[3] - is) * 180 / (im - is),
			  180-(adc_val[4] - ths) * 180 / (thm - ths)
	  	  );
//	  sprintf(str_buffer,"\r\nPinky: %u | Ring: %u | Middle 3: %u | Index 4: %u | Thumb 5: %u \r\n\0",
//			  (adc_val[0]-ps)/(pm-ps)*100,
//			  (adc_val[1]-rs)/(rm-rs)*100,
//			  (adc_val[2]-ms)/(mm-ms)*100,
//			  (adc_val[3]-is)/(im-is)*100,
//			  (adc_val[4]-ths)/(thm-ths)*100);
	  char strbuff2[1];
	  while(HAL_UART_Receive(&huart2,strbuff2,1,50) != HAL_OK) {
//		  sprintf(str_buffer,"WAITING ON COMMAND\n");
//		  HAL_UART_Transmit(&huart2,str_buffer,strlen(str_buffer),5000);
	  }
	  HAL_UART_Transmit(&huart2,str_buffer,5,50);
	  HAL_GPIO_WritePin(LED_GPIO_Port, LED_Pin, GPIO_PIN_RESET);
	  // Send AT

//
//	  char *cmd = "AT\r\n";
//
//	  HAL_UART_Transmit(&hlpuart1, (uint8_t*)cmd, strlen(cmd), 100);
//	  HAL_Delay(100);
//	  // Receive response
//	  char rx[500];
//
//	  int rec = HAL_UART_Receive(&hlpuart1, rx, sizeof(rx), 500);
////	  rx[rec+1]='\0';
//	  char str_buffer2[500];
//	  sprintf(str_buffer2,"\nRead Out from %s %d characters: \r\n\0",cmd,rec);
//
//	  HAL_UART_Transmit(&huart2, str_buffer2, strlen(str_buffer2), 500);
//	  HAL_UART_Transmit(&huart2, rx, rec, 500);


  }
  /* USER CODE END 3 */
}

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
