Nikhil-Vishnoi/RobotHand/(commit log)

2025-09-21 Routing for motor control PCB
    [MotorControl.kicad_pcb, MotorControl.kicad_sch]
2025-09-22 Passing DRC
    [RemoteControl.kicad_pcb, RemoteControl.kicad_sch]
2025-10-01 Motor Control
    [MotorControl.kicad_pcb, MotorControl.kicad_sch]
2025-10-07 Pushing updated servo controller
    [MotorControl.kicad_pcb, MotorControl.kicad_sch]
2025-10-08 Remote Control
    [RemoteControl.kicad_pcb]
2025-10-10 Updated remote control
    [RemoteControl.kicad_pcb]
2025-10-10 Updated Motor Control
    [MotorControl.kicad_pcb]
2025-10-17 final boards
    [MotorControl-B_Cu.gbr, MotorControl-B_Mask.gbr, MotorControl-B_Paste.gbr, MotorControl-B_Silkscreen.gbr, MotorControl-Edge_Cuts.gbr, MotorControl-F_Cu.gbr, MotorControl-F_Mask.gbr, MotorControl-F_Paste.gbr]
2025-10-26 pushing workspace
    [MotorControl-B_Cu.gbr, MotorControl-B_Mask.gbr, MotorControl-B_Paste.gbr, MotorControl-B_Silkscreen.gbr, MotorControl-Edge_Cuts.gbr, MotorControl-F_Cu.gbr, MotorControl-F_Mask.gbr, MotorControl-F_Paste.gbr]
2025-11-30 Remote Control Code
    [STM_RemoteControl Debug.cfg]
2025-12-15 added cad files
