Nikhil-Vishnoi/RobotHand/(notices)

Notices in the files:
STM32_Motor/Core/Inc/main.h:
Copyright (c) 2025 STMicroelectronics.
All rights reserved.
This software is licensed under terms that can be found in the LICENSE file
